Prosper02/endoscope-latency/(commit log)

2026-09-21 EndoLatency: desktop tool for endoscope and telementoring latency measurement
    Qt desktop app that drives the Arduino latency probe, guides sensor placement,
    records runs with their conditions, analyses them and exports HTML/PDF reports.
    Supports two-screen (mentee + mentor) and one-screen setups. Includes the
    firmware, the ten runs of 21 September 2026 as sample data, the technical
    report, and a pytest suite.
2026-09-21 Add app icon, Windows packaging and CI
    - Application icon (endolatency/assets), shown in the window and taskbar
    - build_exe.py: PyInstaller build of a self-contained dist/EndoLatency folder and zip
    - GitHub Actions: tests on push, Windows package attached to v* releases
    - Install instructions for the Windows zip, pip from GitHub, and from source
    - Resource lookup that works from source, site-packages and the frozen bundle
2026-09-21 Restart trial numbering per run, warn when the OFF edge cannot be measured
    - Firmware: 'z' command resets the trial counter; the app sends it at run start
    - Live summary flags a sensor whose lit level sits within 4 counts of dark
    - Timeline figure keeps the legend clear of the data
    [analysis.py, app.py, endoscope_latency.ino]
2026-09-21 Add three validation runs recorded with the application
    - sample_data/2026-09-21-app: three runs recorded with the application, with ping
2026-09-21 Describe the board as an ATmega328 microcontroller; rename the serial class to SerialLink
2026-10-22 Firmware: random 0-200 ms edge delay to decorrelate flashes from the camera frame clock; A3 held HIGH as a sensor supply
2026-10-22 Remove the bundled sample data and report; tests use synthetic runs
    - Analysis tab: drop the Open sample data button
    - build_exe.py: no sample_data in the Windows bundle
    - tests: generate synthetic runs instead of reading recorded ones
    - README: drop the report and sample data references
